YonkeMuffinMan/CollisionSensingHat/(threads)

Thread 3 (2020-03-20):

Motor Vibration

hroudae, 2020-03-20:
make motor vibrate using PWM

Closed 2020-03-24.

Thread 7 (2020-03-24):

Vary Motor Vibration

hroudae, 2020-03-24:
Vary the motor vibration by changing the PWM duty cycle

Closed 2020-03-29.
