YonkeMuffinMan/CollisionSensingHat/CollisionSensor/Src/lcd.h

/*
 * File: lcd.h
 * Purpose: Declares all functions and stucts pertaining to the setup and
 *          communication with the Nokia 5110 LCD Screen. All communication
 *          is via SPI2 using GPIOB pins.
 */
#ifndef __LCD_H
#define __LCD_H

#include "stm32f0xx_hal.h"

// some command bytes
#define COMMAND_DISPLAY_FILL  0x09
#define COMMAND_DISPLAY_INVERSE 0x0D
#define COMMAND_DISPLAY_NORMAL 0x0C
#define COMMAND_EXTENDED_INSTRUCTION 0x21

#define COMMAND_RESET_X 0x80
#define COMMAND_RESET_Y 0x40

/*
 * Table that converts a char to LCD display, starting with the Space (' ') character
 * ascii_to_lcd[c - ' '] will get the LCD data sequence for character c
 * each is 5 columns x 8 rows on the LCD
 */
static uint8_t ascii_to_lcd[][5] = {
	{ 0x00, 0x00, 0x00, 0x00, 0x00 }, // 0x20 Space
	{ 0x00, 0x00, 0xBE, 0x00, 0x00 }, // 0x21 !
	{ 0x00, 0x06, 0x00, 0x06, 0x00 }, // 0x22 "
	{ 0x44, 0xfe, 0x44, 0xfe, 0x44 }, // 0x23 #
	{ 0x5c, 0x54, 0xfe, 0x54, 0x74 }, // 0x24 $
	{ 0x44, 0x20, 0x10, 0x08, 0x44 }, // 0x25 %
	{ 0x6c, 0x92, 0xb2, 0x4c, 0xa0 }, // 0x26 &
	{ 0x00, 0x00, 0x06, 0x00, 0x00 }, // 0x27 '
	{ 0x00, 0x38, 0x44, 0x82, 0x00 }, // 0x28 (
	{ 0x00, 0x82, 0x44, 0x38, 0x00 }, // 0x29 )
	{ 0x28, 0x10, 0x7c, 0x10, 0x28 }, // 0x2a *
	{ 0x10, 0x10, 0x7c, 0x10, 0x10 }, // 0x2b +
	{ 0x00, 0xb0, 0x70, 0x00, 0x00 }, // 0x2c ,
	{ 0x10, 0x10, 0x10, 0x10, 0x10 }, // 0x2d -
	{ 0x00, 0xc0, 0xc0, 0x00, 0x00 }, // 0x2e .
	{ 0xc0, 0x60, 0x38, 0x0c, 0x06 }, // 0x2f /
	{ 0x7c, 0xc2, 0xba, 0x86, 0x7c }, // 0x30 0
	{ 0x84, 0x84, 0xFE, 0x80, 0x80 }, // 0x31 1
	{ 0xC4, 0xA2, 0x92, 0x8C, 0x00 }, // 0x32 2
	{ 0x82, 0x92, 0x92, 0x6C, 0x00 }, // 0x33 3
	{ 0x1E, 0x10, 0xFE, 0x10, 0x00 }, // 0x34 4
	{ 0x9E, 0x92, 0x92, 0x62, 0x00 }, // 0x35 5
	{ 0xFE, 0x92, 0x92, 0xF2, 0x00 }, // 0x36 6
	{ 0x02, 0xC2, 0x32, 0x0E, 0x00 }, // 0x37 7
	{ 0x6C, 0x92, 0x92, 0x6C, 0x00 }, // 0x38 8
	{ 0x9E, 0x92, 0x92, 0xFE, 0x00 }, // 0x39 9
	{ 0x00, 0x66, 0x66, 0x00, 0x00 }, // 0x3a :
	{ 0x00, 0xB6, 0x76, 0x00, 0x00 }, // 0x3b ;
	{ 0x00, 0x10, 0x28, 0x44, 0x00 }, // 0x3c <
	{ 0x28, 0x28, 0x28, 0x28, 0x28 }, // 0x3d =
	{ 0x00, 0x44, 0x28, 0x10, 0x00 }, // 0x3e >
	{ 0x04, 0x02, 0xA2, 0x12, 0x0C }, // 0x3f ?
	{ 0x3C, 0x5A, 0x9A, 0xA2, 0x1C }, // 0x40 @
	{ 0xF8, 0x24, 0x22, 0x24, 0xF8 }, // 0x41 A
	{ 0xFE, 0x92, 0x92, 0x92, 0x6C }, // 0x42 B
	{ 0x38, 0x44, 0x82, 0x82, 0x82 }, // 0x43 C
	{ 0xFE, 0x82, 0x82, 0x44, 0x38 }, // 0x44 D
	{ 0xFE, 0x92, 0x92, 0x82, 0x00 }, // 0x45 E
	{ 0xFE, 0x12, 0x12, 0x02, 0x00 }, // 0x46 F
	{ 0x7C, 0x82, 0x82, 0x92, 0x74 }, // 0x47 G
	{ 0xFE, 0x10, 0x10, 0x10, 0xFE }, // 0x48 H
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
};
	
// Holds which GPIOB pins communicate with LCD
typedef struct {						// Pin Numbers on LCD
  uint8_t sclk;							// Pin 7, SCLK - SPI Pin
  uint8_t data_in;					// Pin 6, DN(MOSI) - SPI Pin
	uint8_t chip_select;			// Pin 3, SCE - active low
	uint8_t mode_select;			// Pin 5, D/C - command low, data high
	uint8_t reset;						// Pin 4, RST - active low
} LCD;

void LCD_Setup(LCD *screen);

// Functions for sending bytes
void LCD_SendByte(char c);
void LCD_SendCommand(char c);
void LCD_SendData(char c);

// command functions
void LCD_Startup(void);
void LCD_ClearDisplay(void);
void LCD_ClearRow(uint8_t y, uint8_t x);
void LCD_InverseDisplay(void);
void LCD_NormalDisplay(void);
void LCD_ResetX(void);
void LCD_ResetY(void);
void LCD_Reset(void);
void LCD_SetX(uint8_t x);
void LCD_SetY(uint8_t y);

// printing characters on the screen
void LCD_PrintCharacter(char c);
void LCD_PrintString(char* str, int sz);
void LCD_PrintAll(void);
void LCD_PrintStringCentered(char* str, uint8_t sz);

// printing measurements to the screen
void LCD_DistanceSetup(void);
void LCD_PrintMeasurement(uint16_t dist, char* units, uint8_t units_sz);
void LCD_PrintTempMeasurement(uint16_t temp, char* units, uint8_t units_sz, uint16_t temp2, char* units2, uint8_t units_sz2);
uint8_t uintToStr(char* buf, uint16_t dist);

// Pin configuration
void configPinB_AF0(uint8_t x);
void configGPIOB_output(uint8_t pin);


#endif /* __LCD_H */
