YonkeMuffinMan/CollisionSensingHat/(commit log)

2020-03-20 Issue 1: Project Setup
    Created an MDK-ARM project including all the STM header and assembly files needed.
2020-03-24 Initial Motor Vibration
    Motor connected between GND and PB4 will vibrate using PWM.
2020-03-24 #3 Motor Vibration
    Motor connectend between GND and PB4 will vibrate with PWM.
2020-03-29 Motor Speed Vaired
    Closes #7
    Moved PWM setup into motor.c and motor.h
    Added function setDutyCycle which sets the duty cycle to that percentage
    Right now, motor assumes on pin GPIOB, TIM3, PWM CH1, and pin AF1
2020-04-02 USART w/ Distance Sensor
    Closes #9
    Successfully gets distance reading from the Ultrasonic Distance Sensor and sets the correct LED and motor intensity.
    [motor.h, ultrasonicSensorUart.c, ultrasonicSensorUart.h]
2020-04-11 Timer & LCD
    Added the 100 ms timer interrupt to get data and set warnings
    Added support for displaying the distance on an LCD screen that communicates over SPI
2020-04-17 Started README
    Started the writing the README
    Changed pin B12->B7 for the LCD chip select
2020-04-18 README update
    README has been update
    A "OUT OF RANGE" warning has been added to the LCD screen code that will be printed when outside the range of the distance sensor.
    Uncommented the line that sets the vibration intensity
    [lcd.c]
2020-04-20 README Update and Code Cleanup
    Software setup added to README and some formatting updates.
    Header comments added to files along with some other comment clarity changes.
    Some MOTOR_Setup, SENSOR_Setup, and LCD_Setup changed to pass the relevant structs by reference
2020-05-22 Temperature
    Added temperture sensing and display
2020-05-22 Update main.c
    Uncommented setting motor vibration
